0xnullsect0r/MotoGlow/cad/stl/motoglow_tube_saddle.stl

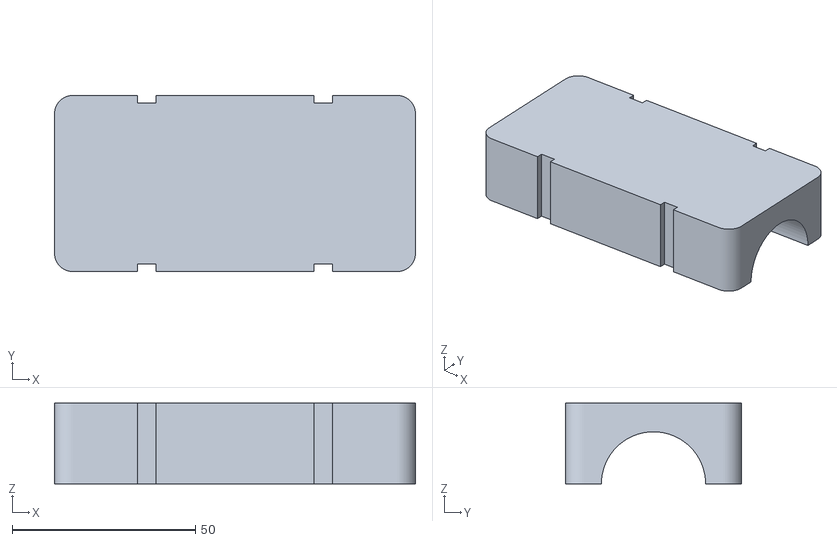
[picture p1: CAD file, 2026-09-21]
cad/stl/motoglow_tube_saddle.stl
98.4 x 48.0 x 22.0
