0xnullsect0r/MotoGlow/cad/stl/motoglow_strip_endcaps_x4.stl

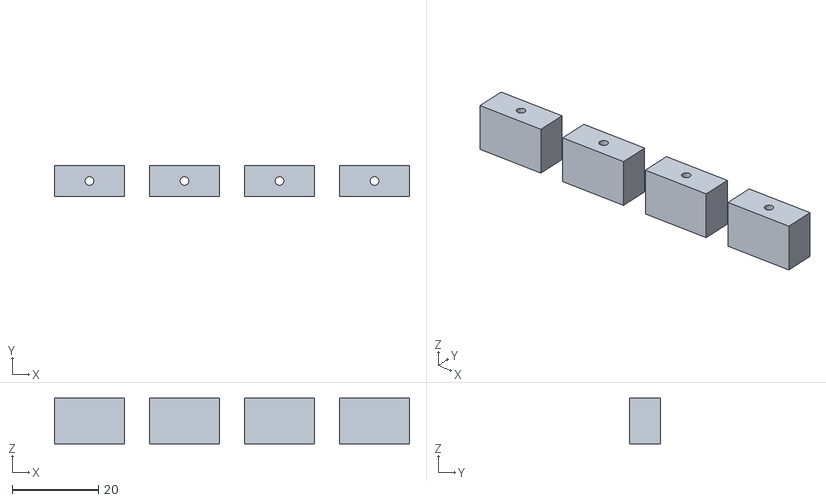
[picture p2: CAD file, 2026-09-21]
cad/stl/motoglow_strip_endcaps_x4.stl
82.2 x 7.20 x 10.6
