0xnullsect0r/MotoGlow/cad/stl/motoglow_case_tub.stl

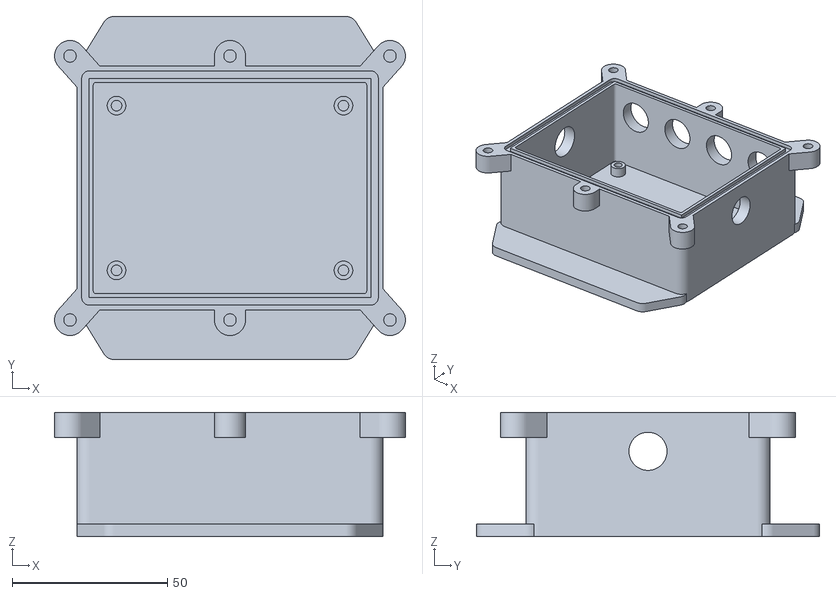
[picture p3: CAD file, 2026-09-21]
cad/stl/motoglow_case_tub.stl
112.9 x 110.4 x 39.9
