0xnullsect0r/MotoGlow/cad/stl/motoglow_case_lid.stl

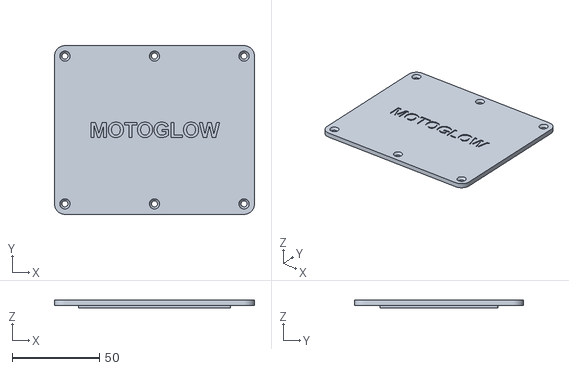
[picture p4: CAD file, 2026-09-21]
cad/stl/motoglow_case_lid.stl
114.9 x 96.9 x 4.50
