0xnullsect0r/MotoGlow/cad/stl/motoglow_strip_clips_x8.stl

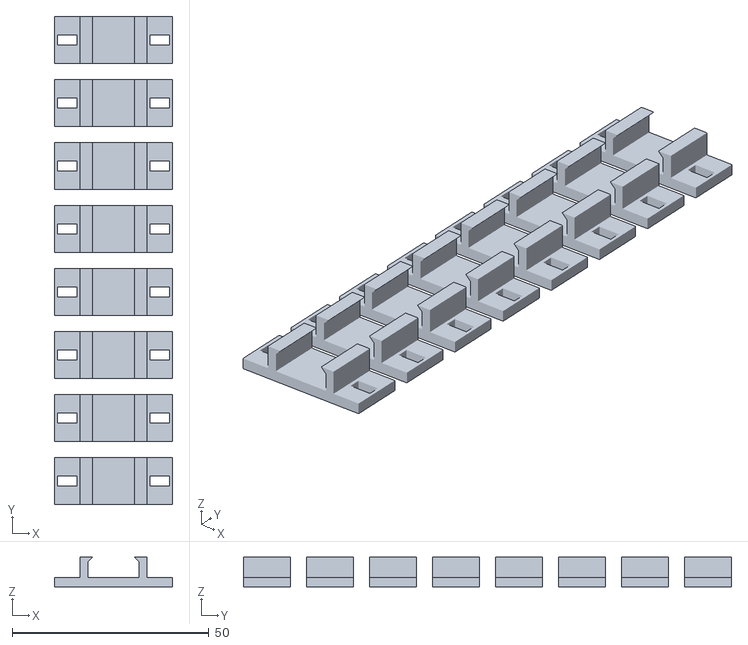
[picture p5: CAD file, 2026-09-19]
cad/stl/motoglow_strip_clips_x8.stl
30.0 x 124.0 x 7.60
