0xnullsect0r/MotoGlow/cad/pcb_data.scad

// GENERATED by hardware/motoglow-pcb/export_pcb_data.py -- do not edit.
// Regenerate after any change to the board or to mech.py, then re-run
// hardware/motoglow-pcb/verify_fit.py before printing anything.

pcb_x        = 80.0;
pcb_y        = 60.0;
pcb_t        = 1.6;
pcb_standoff = 4.0;
// Mounting holes in BOARD coordinates, origin at the board's bottom-left.
pcb_holes    = [[3.5,3.5], [3.5,56.5], [76.5,3.5], [76.5,56.5]];

case_margin  = 4.0;     // board edge to the inside face of the wall
case_floor_t = 2.8;
case_inner_h = 37.1;
port_z       = 24.6;   // above the inside floor

// [face, position along that face in board coords, hole dia, flange dia, label]
// face: "W" = board x=0 wall, "E" = x=pcb_x, "N" = y=0, "S" = y=pcb_y
ports = [
  ["S", 7.0, 13.2, 20.0, "RUN0 left chain"],
  ["S", 29.0, 13.2, 20.0, "RUN1 right chain"],
  ["S", 51.0, 13.2, 20.0, "RUN2 engine"],
  ["S", 73.0, 13.2, 20.0, "RUN3 tail"],
  ["W", 30.0, 13.2, 20.0, "handlebar"],
  ["E", 30.0, 12.2, 18.0, "battery feed"],
];
