0xnullsect0r/MotoGlow/(list of files, drawings)

Other design files:
hardware/motoglow-pcb/motoglow.dsn
