0xnullsect0r/MotoGlow/hardware/motoglow-pcb/motoglow.kicad_pcb

## KiCad design hardware/motoglow-pcb/motoglow.kicad_pcb (2026-09-21)

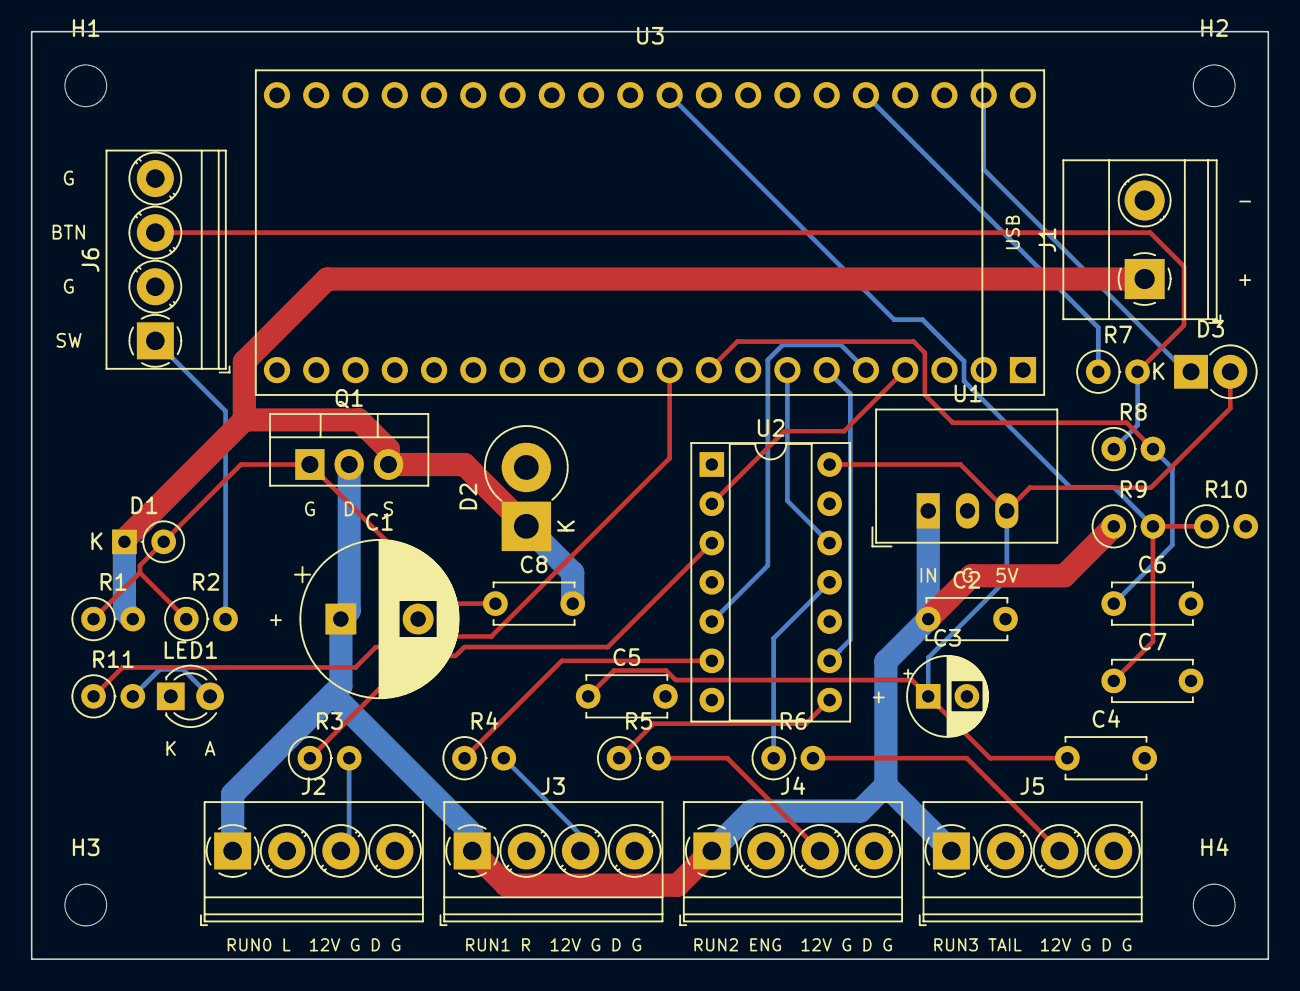
[picture p6: board motoglow.kicad_pcb from above]

Board: 2 copper layers, 80.0 x 60.0 mm, 37 parts (0 on the bottom side), 25 nets.

Parts:
C1: 470uF 35V; CP_Radial_D10.0mm_P5.00mm
C2, C4, C5, C6, C7, C8: 100nF; C_Disc_D5.0mm_W2.5mm_P5.00mm
C3: 10uF 16V; CP_Radial_D5.0mm_P2.50mm
D1: BZX55C15; D_DO-35_SOD27_P2.54mm_Vertical_KathodeUp
D2: 1.5KE18A; D_DO-201AD_P3.81mm_Vertical_KathodeUp
D3: 1N5819; D_DO-41_SOD81_P2.54mm_Vertical_KathodeUp
H1, H2, H3, H4: M2.5; MountingHole_2.7mm_M2.5
J1: 12V IN; TerminalBlock_Phoenix_MKDS-1,5-2-5.08_1x02_P5.08mm_Horizont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
J2: RUN0 L; TerminalBlock_Phoenix_PT-1,5-4-3.5-H_1x04_P3.50mm_Horizontal
J3: RUN1 R; TerminalBlock_Phoenix_PT-1,5-4-3.5-H_1x04_P3.50mm_Horizontal
J4: RUN2 ENG; TerminalBlock_Phoenix_PT-1,5-4-3.5-H_1x04_P3.50mm_Horizontal
J5: RUN3 TAIL; TerminalBlock_Phoenix_PT-1,5-4-3.5-H_1x04_P3.50mm_Horizontal
J6: BAR; TerminalBlock_Phoenix_PT-1,5-4-3.5-H_1x04_P3.50mm_Horizontal
LED1: STATUS; LED_D3.0mm
Q1: IRF4905; TO-220-3_Vertical
R1: 100k; R_Axial_DIN0207_L6.3mm_D2.5mm_P2.54mm_Vertical
R2, R7, R10: 10k; R_Axial_DIN0207_L6.3mm_D2.5mm_P2.54mm_Vertical
R3, R4, R5, R6: 330; R_Axial_DIN0207_L6.3mm_D2.5mm_P2.54mm_Vertical
R8: 1k; R_Axial_DIN0207_L6.3mm_D2.5mm_P2.54mm_Vertical
R9: 47k; R_Axial_DIN0207_L6.3mm_D2.5mm_P2.54mm_Vertical
R11: 470; R_Axial_DIN0207_L6.3mm_D2.5mm_P2.54mm_Vertical
U1: R-78E5.0-1.0; Converter_DCDC_RECOM_R-78E-0.5_THT
U2: 74AHCT125N; DIP-14_W7.62mm_Socket
U3: Pico 2 W; RPi_Pico_2W_Horizontal

Connections:
+3V3: R7.1, U3.36
+5V: C3.1, C4.1, C5.1, D3.2, U1.3, U2.14
+12VSW: C1.1, C2.1, J2.1, J3.1, J4.1, J5.1, Q1.2, R9.1, U1.1
BAT+: C8.2, D1.1, D2.1, J1.1, Q1.3, R1.2
BTN: J6.3, R7.2, R8.1
DATA0: J2.3, R3.2
DATA1: J3.3, R4.2
DATA2: J4.3, R5.2
DATA3: J5.3, R6.2
GATE: C8.1, D1.2, Q1.1, R1.1, R2.1
GND: C1.2, C2.2, C3.2, C4.2, C5.2, C6.2, C7.2, D2.2, J1.2, J2.2, J2.4, J3.2, J3.4, J4.2, J4.4, J5.2, J5.4, J6.2, J6.4, LED1.1, R10.2, U1.2, U2.1, U2.4, U2.7, U2.10, U2.13, U3.3, U3.8, U3.13, U3.18, U3.23, U3.28, U3.33, U3.38
GP2: U2.2, U3.4
GP3: U2.5, U3.5
GP4: U2.9, U3.6
GP5: U2.12, U3.7
GP6: C6.1, R8.2, U3.9
GP7: R11.1, U3.10
LED_A: LED1.2, R11.2
SW_A: J6.1, R2.2
VSENSE: C7.1, R9.2, R10.1, U3.31
VSYS: D3.1, U3.39
Y1: R3.1, U2.3
Y2: R4.1, U2.6
Y3: R5.1, U2.8
Y4: R6.1, U2.11
