0xnullsect0r/MotoGlow/(commit log)

2026-09-19 Add MotoGlow firmware, enclosure CAD, and direction-invariant tests
    Bike-space animation engine for addressable accent lighting on a KTM 890
    Adventure, targeting a Pico 2 W driving four 12 V WS2811 COB runs.
    The central design decision is that animations are never written against LED
    indexes. Every pixel is assigned a physical (x, y, side) position on the
    motorcycle in bike_map.cpp, and effects render as a function of that position
    and time. A block "flowing front to rear" therefore flows front to rear across
    the real bike regardless of which strip a pixel belongs to, which direction that
    segment was soldered, or how large the gaps between segments are.
    That invariant is enforced in exactl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
    [motoglow_case.scad, motoglow_case_lid.stl, motoglow_case_tub.stl, motoglow_strip_clips_x8.stl, motoglow_strip_endcaps_x4.stl, motoglow_tube_saddle.stl, params.scad, strip_parts.scad]
2026-09-19 Add MotoGlow controller PCB, generated and geometrically verified
    Two-layer 80x60 mm all-through-hole board: P-channel MOSFET master switch,
    TVS-based reverse polarity protection, RECOM switching regulator, 74AHCT125
    level shifter for the four strip data lines, and a Pico 2 W on a generated
    footprint.
    The board is produced by script rather than drawn. gen_board.py holds the
    placement and netlist, route.py exports Specctra DSN, drives freerouting and
    imports the session back, and verify_board.py checks the result. KiCad 7's CLI
    cannot export DSN and has no drc subcommand, so both ends of that pipeline are
    written here.
    Three things this pipeline got wrong before it got them right, all caugh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
    [motoglow-B_Cu.gbl, motoglow-B_Mask.gbs, motoglow-B_Silkscreen.gbo, motoglow-Edge_Cuts.gm1, motoglow-F_Cu.gtl, motoglow-F_Mask.gts, motoglow-F_Silkscreen.gto, motoglow-NPTH.drl]
2026-09-19 Add documentation and align the firmware current cap with the board
    Parts list, wiring, build guide, bike-map worksheet and preset reference, plus
    a top-level README.
    MAX_STRIP_CURRENT_MA drops from 4000 to 2500. The stock 69-pixel build cannot
    draw more than 2.88 A even with every pixel at full white, so a 4 A cap was a
    number that could never engage. 2500 mA sits below the physical ceiling and
    above nothing the animations actually do, with the PCB's 1.5 mm power traces
    good for about 3.7 A and a 5 A fuse behind them.
    Claude-Session: https://claude.ai/code/session_01BdW1CR3ybYE86jRg6J66BD
2026-09-19 Add the preset bench: a live previewer for all sixteen presets
    A single-file page that ports the animation engine to JavaScript and renders it
    on a side elevation of the bike, drawn in the same bike-space coordinates the
    firmware uses. The segment positions, pixel counts, all eight motion primitives,
    the palettes, the speed and brightness tables, the 400 ms crossfade and the
    power-on sequence are all mirrored from the C++ rather than approximated.
    It also runs the firmware's own current estimator, so the readout showing Chrome
    pushing into the 2500 mA limiter while Midnight sits near nothing is real
    information about the build rather than decoration.
    Two things are deliberately not faithfu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
2026-09-21 Rev B: make the board and the enclosure fit each other, and prove it
    Revision A had both halves verified and mutually impossible. The case was built
    for a 75 x 55 mm board that had become 80 x 60, its four posts missed the real
    mounting holes by 2.5 mm on each axis, and all six panel connectors' bodies
    landed inside components -- 19 collisions. Nothing in the project compared the
    two, so nothing complained.
    mech.py now holds every number that couples them and both sides read it. The
    case no longer keeps its own copy of the board size, hole positions or port
    list: export_pcb_data.py writes those from the real board into pcb_data.scad,
    and cad/build.sh runs the exporter and verify_fit.py befo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
    [motoglow-B_Cu.gbl, motoglow-B_Mask.gbs, motoglow-B_Silkscreen.gbo, motoglow-Edge_Cuts.gm1, motoglow-F_Cu.gtl, motoglow-F_Mask.gts, motoglow-F_Silkscreen.gto, motoglow-NPTH.drl]
